Aekkee/YB-Phoenix/1. Team and Robot Picture/Right robot view.jpg

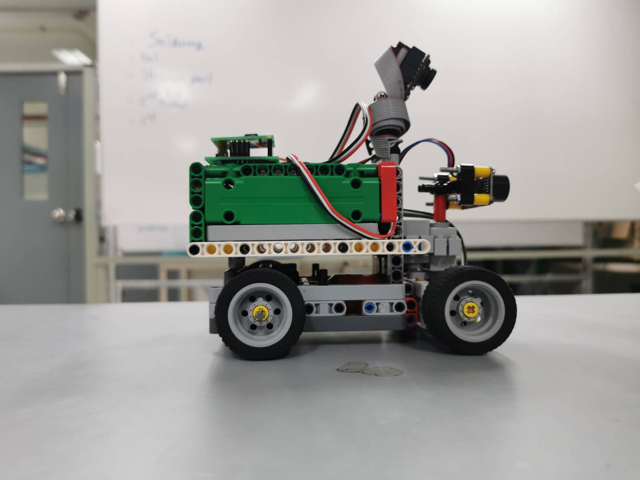
1. Team and Robot Picture/Right robot view.jpg
