Aekkee/YB-Phoenix/National Round (For EV3 users)/README.md

# WRO Future Engineer EV3 Program [Pheonix]
### _By [Yothinburana School Robot Club]_

N|Solid (https://nodesource.com/products/nsolid)

## Youtube Links: 
Currently Unavaiable 

## This Github repository contains:

- Our robot design
- In-depth program explaination
- Other links and references

## **Our Robot Design** ✨
### **Robot Hardware** 💻

- **Motor** - **Power Functions L-Motor (88003)** for **moving** our robot
- **2 Servo** - **KSERVO-270** one for **steering** our robot and another for **rotating ultrasonic sensor**
- **Compass or Gyro** - We use **CMPS-03** compass
- **Camera** - We use **Pixy 2.1** for our robot because of its functionality along with the existing pre-made blocks by the developers
- **Maker Nano RP2040** - The brain for our robot
- **HC-SR04** - An ultrasonic sensor used to measure the distance between the robot and walls  

## **Program Explaination**
### ✨ Our Robot Features ✨

- Proportional Integral Derivative (PID) controlled steering 🚗
- 

As for replicating our robot, we have a **step by step** guide for you.👍

⚠️ **Please note that:** ⚠️
> **We are using LEGO MINDSTORM EV3 for this project.**
> If you **do not** have LEGO MINDSTORM EV3 or are planning on using other microcontrollers I suggest you read this document carefully and please use our program as a guide.

[![N|Solid](https://lh3.googleusercontent.com/fife/AAbDypBhkuFr3Mr7tSym3Jut6JyhcBHJF3AeRYTrl4BHX1edeHbYBvMCN0v1G-UvhWVuRADE4BjWsHMhKEY4IB6p_8vBIARpBFdUQgE92JAFT-g76NMN9wx3w2ewer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)](https://nodesource.com/products/nsolid)

# **1. Setting up your Board and Arduino Software** 🤖
⚠️ **Please Note that** ⚠️
> We are using **Maker nano RP2040** from Cytron Technologies which would need a custom board library

For more information: [Arduino-pico Github]

### **Required Programs**

- **[EV3 Education Lab]** - For Programming your EV3
- **[Pixymon V2]** - For displaying and configuring your Pixy

### **Custom blocks used in EV3 Education Lab**

You need to download these custom made programming blocks to open our program files

- **[OFDL-EV3_Blocks-Collections]** - Add more useful blocks to programming environment
- **[Pixy Blocks and Examples]** - Pixy blocks for your EV3 software with example files

# **2. Programming** 💻
Finally we got to the interesting part ✨
Please, download our EV3 program as a reference, so you can better understand our explainations.

### **Part one:** Setup
This part of our program includes:
- **Determining the robot's direction**  
![](https://lh3.googleusercontent.com/fife/AAbDypD19ichivSvKgow7SBUhvRISVjbeEnMqtdiLCfeoiHsTXGTynDmHaaABd05Rx9MwXgOLXVgILLlzxY_UNUFkmNNxtJBrDTvoTLwKNRpVTRh5O3Hdc8KCTfvFB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)
- **Indicate low battery warning**  
![](https://lh3.googleusercontent.com/fife/AAbDypDL6udCDNcrJpbI75eJKVTb2XgOOONblajD7lleT2Ds3tAuYmS1voNpj4O4uy9p_68-gk1LyinkShpxCgeH9lBCz65OSZfb7PZ5uLUNbl8x__WX-aaYrAVg82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)
- **Move the steering wheels to face the correct position**  
![](https://lh3.googleusercontent.com/fife/AAbDypDoBCUtBNHInyxUW6POKqjqlr32bJ9cwkqRGxk00nqvwL63Sdkmf8O42UpXM3SDPoTTlRFafiBpHbO5Z_WzKHs8AJyCZEET8uj4ZCkqxJmPGTmIcoX5jFx5Ec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)

### **Part two:** Block detection and Robot steering
- **Color detection using Pixy**  
![](https://lh3.googleusercontent.com/fife/AAbDypDo2WOmB2DtCV5U8sR4sGLe_OFGH4g9Vg7N4PIIYmCPscsrt0QWxGzkq1nmktyN6a8tPilJGx2e8ksjzy-kOQZRomiHENlKFdOPSClxG0ji696qcPnnTdN3SC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)
Basically, this part of the program identify which color the Pixy finds. The instructions are as follows:
    - **Adjust robot's path using color signature**  
    ![](https://lh3.googleusercontent.com/fife/AAbDypDAMWveU2Jn_tNErXpLFKThiTEFp8UaaCS-FhQRa7MCt7lQyf8qnEGoLuunH8VuOOTt_DcB_7IdZC9x-ejX6VenEZGjx1oavyO-VwAok2_8s6zkEdiX2gOoWB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)  
    If color is **Red** then **Shift the robot to the right of the block**  
    If color is **Green** then **Shift the robot to the left of the block**  
    ![](https://lh3.googleusercontent.com/fife/AAbDypD4QLQ8vNnnWWcWHOAoVVmfWXYSTS6NW5RJBFBDBHkialNd3rFpNd5DHWMveuq5Bj2PTGkPQn3MXbVjopW1ivrxxkPY_Fma1_2BDrIZE0OYaydA4m9A4oUFFg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)
To put it simple, we are using the **quadratic bezier curve formula** to determine the direction of the robot.

        **But what is a Bezier Curve?**
        > **Bezier Curve** is a parametric curve used in computer graphics and related fields. A set of discrete "control points" defines a smooth, continuous curve by means of a formula. Usually the curve is intended to approximate a real-world shape that otherwise has no mathematical representation or whose representation is unknown or too complicated.  
        
        > **More information about Bezier Curve: [Wikipedia - Bezier Curve] ✨**

        **📌 In our case, we have 4 control points 📌**

        The formula is as follows:  
![](https://lh3.googleusercontent.com/fife/AAbDypATYAYSVzyFyzcO9Y8Lw_bHWmurQLr3pwpLvbIba9qZj3SMmVark8kveDfTkpM0Uf40ed9B-4JJlOhpJCVH2EHxdFsrdnev0wNIUWe1pR4FZqAfuLhohlUk9l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)
        > After we get the **X and Y coordinate** that the robot needs to travel to, we'll **convert that to degrees for the steering wheel motor** by using the following program:  
        
        ![](https://lh3.googleusercontent.com/fife/AAbDypAHzC5M0sBhdJrIlU6XGnXttiSh6ecebvcLrEsPlhhEmdPpX6r7i-wGedJ7vKiie4GmZrbdCkSyfcnlYBCvb7sVNiamjRPEgi-3l1EJ_s702CBq9FDJccZusX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)
    - Adjust robot’s direction by 90 degrees after reaching the turning area  
    ![](https://lh3.googleusercontent.com/fife/AAbDypAqPszHc3wmX25lIkUjvuigtjvkh02RBT9zwXJ_AV8qzvOGWG_Vpqs71u0O5IG7VIEkLieK5CH3fCuK2qOO1kZW4_OymK612jlIEYURUE1EoBGEnZ_VWWkTDZ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)  
    If color is **Blue** then **Adjust the robot's default direction by 90 degrees**  
    ![](https://lh3.googleusercontent.com/fife/AAbDypDWXd5mWcKKQ-gScPsW1K7Q_ZRWQ9TaznbvolquV0dytodjZB6YHIp6K6jnizyMi9ScjEapgEU8xmqhEPYtdyP9QoAFFB_UfUe0PTkm0Pn3gBY1REboFXnHOX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)

### **Part Three:** Critical positions detection
> This part of the program is for **detecting undesired headings of the robot** caused by camera's blocks positions errors, equation errors, etc. 

##### 🟡 A little suggestion from our perspective, 
## we do highly suggest you to ⚠️ **never create a safety critical system** ⚠️ that have a single point of failure. 🍌
We can never rely on the programs we create, so just in case any error occurs, this program would help.

#
#
# 🟢 **[Detection 1]:** Near-hit detection
#### Using the height of the signatures detected by Pixy camera, and the height of the blocks which is 10 centimeter in real life as a reference, **we can calculate the distance between the camera and the blocks!**

> **Formula for calculating the distance of an object:** distance = size_obj * focal_length / size_obj_on_sensor

The program are as follows:  
![](https://lh3.googleusercontent.com/fife/AAbDypCjLyQjF2vqpZjaAAG-T0slBqm0HV24ctHKi_UvyoXKyNPbJK6ab1D-ZnFg1ww3Nec48ieyfoIoRNK_Yg1p1w6CH5ynffmCxAasNZwluHsmaNQroIheo3PfHd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)
##### If the robot detect that it will hit a wall or a block,
#### **the robot will drive in reverse.** ◀️

#
#
# 🟢 **[Detection 2]:** Backup steering
#### This program adjusts the heading of the robot by using values from Pixy camera and Ultrasonic sensors on both side of the robot to **add or subtract the heading degree after the bezier calculation.**  
![](https://lh3.googleusercontent.com/fife/AAbDypDV3Rtvpgkvh6gzzoqJ7U51JMFcOq5YxxtGYS0TlrxSY1K6V_JZgZnD2zn65zdZEs3bwnZTrf989OlazfbahByidTy8rnCBnAsqU0yjdOSmdzYOqjEByyz8x_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)

### **Part Four:** More
The programs in this part is optional and have little effect on the game.
- **Camera test**
Test if the camera is connected to the EV3 MINDSTORM port  
![](https://lh3.googleusercontent.com/fife/AAbDypAMXlgUzxccWHEoJ7KWykB7f46ujeOkY6n4Qe4_v1R4l5G3kUDCIg8IgOFlzirzIxJD7mtJjygEHpQGzEgMt2Sz-Fjoqggl1YK8VXD_W-1kpyogWZsbo4bqEQ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)
- **Compass calibration**
Calibrate the compass  
![](https://lh3.googleusercontent.com/fife/AAbDypBfSTRP_zLe6ElJU3DmDhECoI8SUKoXrNoVhygPmR-7G5bZrRr5LaoHGOdHfR2g08ff1kFfpsh0VxV0GMlQW-b5_oHd6iEwsv-ilc_BkdtpIgDJ6gRUlRCHMP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)

### **Part Five:** Stopping the robot
This part of the robot ensures that the robot **stops in the correct position on the field.**
Basically, the program counts how many time the robot took a 90 degree turn
If it turns more than 4 times the program will run for 1.5 second and the program ends.

# **THE END**
For further questions please email robloxplay41@gmail.com

   [Yothinburana School Robot Club]: <https://ybrobot.club/>
   [Original Flipped Digital Lab]: <https://ofdl.tw/en/>
   [EV3FW-V1.21C-OFDL.bin]: <https://github.com/a10036gt/EV3-BatteryInfo-Block/releases/download/v1.2/EV3FW-V1.21C-OFDL.bin>
   [OFDL-EV3_Blocks-Collections]: <https://github.com/a10036gt/OFDL-EV3_Blocks-Collections/releases/tag/2020.09.12>
   [Pixy Blocks and Examples]: <https://github.com/charmedlabs/pixy/raw/master/releases/lego/lego_pixy-1.1.4.zip>
   [EV3 Education Lab]: <https://e498eb58-16e9-491c-8ce4-828510ab7c41.filesusr.com/archives/1f66bb_4708cf7510f64585bd447c26a4110fc5.zip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>
   [Pixymon V2]: <https://github.com/charmedlabs/pixy/raw/master/releases/pixymon_windows/pixymon_windows-2.0.9.exe>
   [Wikipedia - Bezier Curve]: <https://en.wikipedia.org/wiki/B%C3%A9zier_curve>
   [Arduino-pico Github]: <https://github.com/earlephilhower/arduino-pico>
