Aekkee/YB-Phoenix/1. Team and Robot Picture/Back robot view.jpg

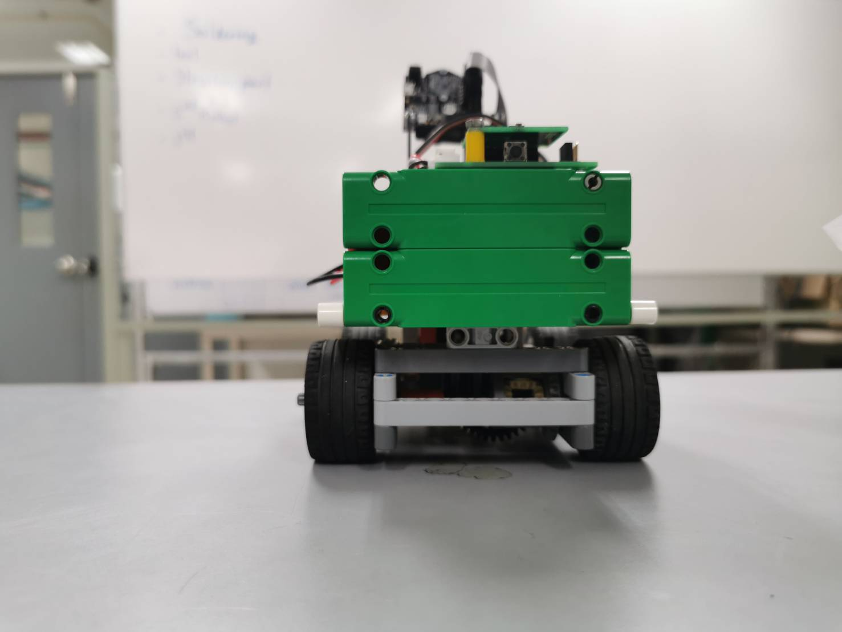
1. Team and Robot Picture/Back robot view.jpg
