Aekkee/YB-Phoenix/1. Team and Robot Picture/Bottom robot view.jpg

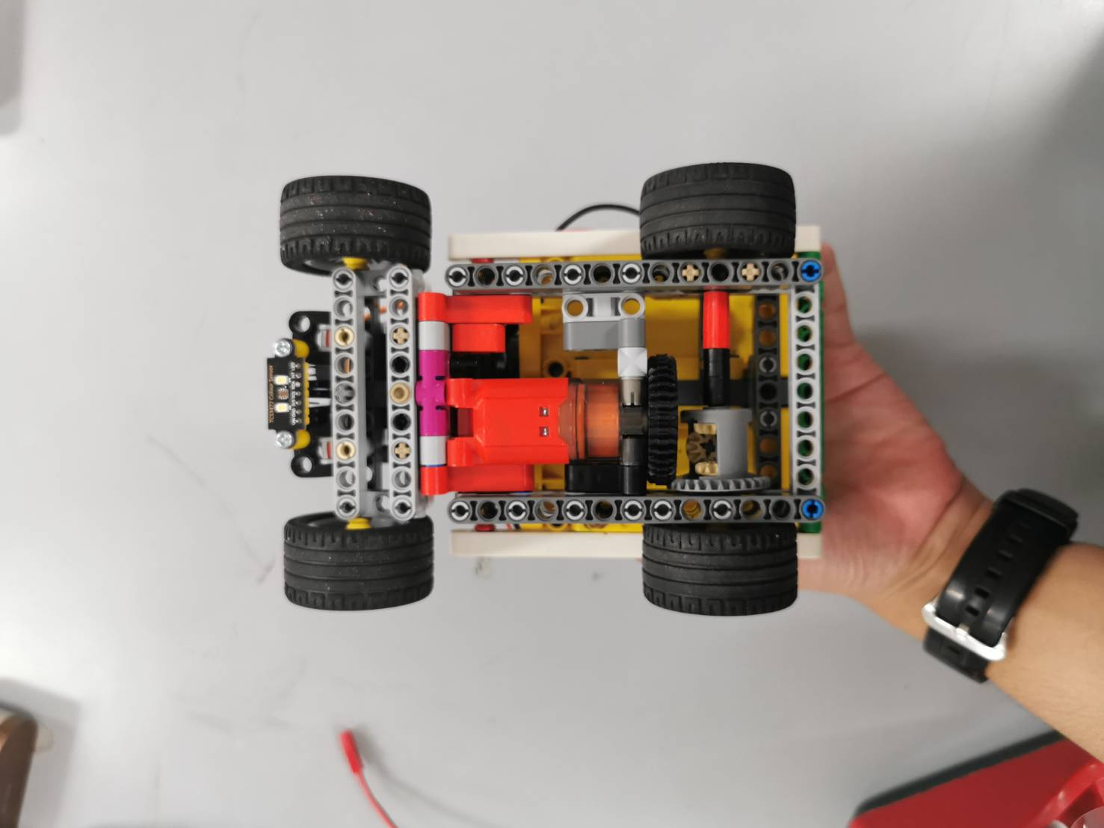
1. Team and Robot Picture/Bottom robot view.jpg
