Aekkee/YB-Phoenix/1. Team and Robot Picture/Front robot view.jpg

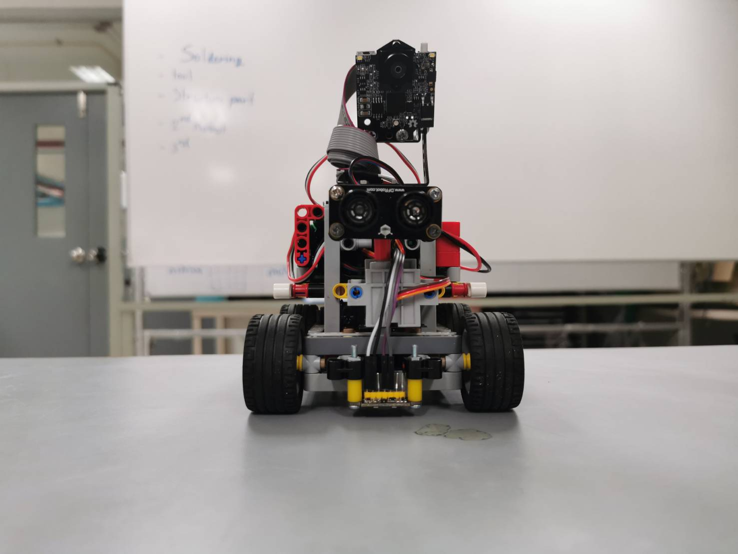
1. Team and Robot Picture/Front robot view.jpg
