Aekkee/YB-Phoenix/1. Team and Robot Picture/Left robot view.jpg

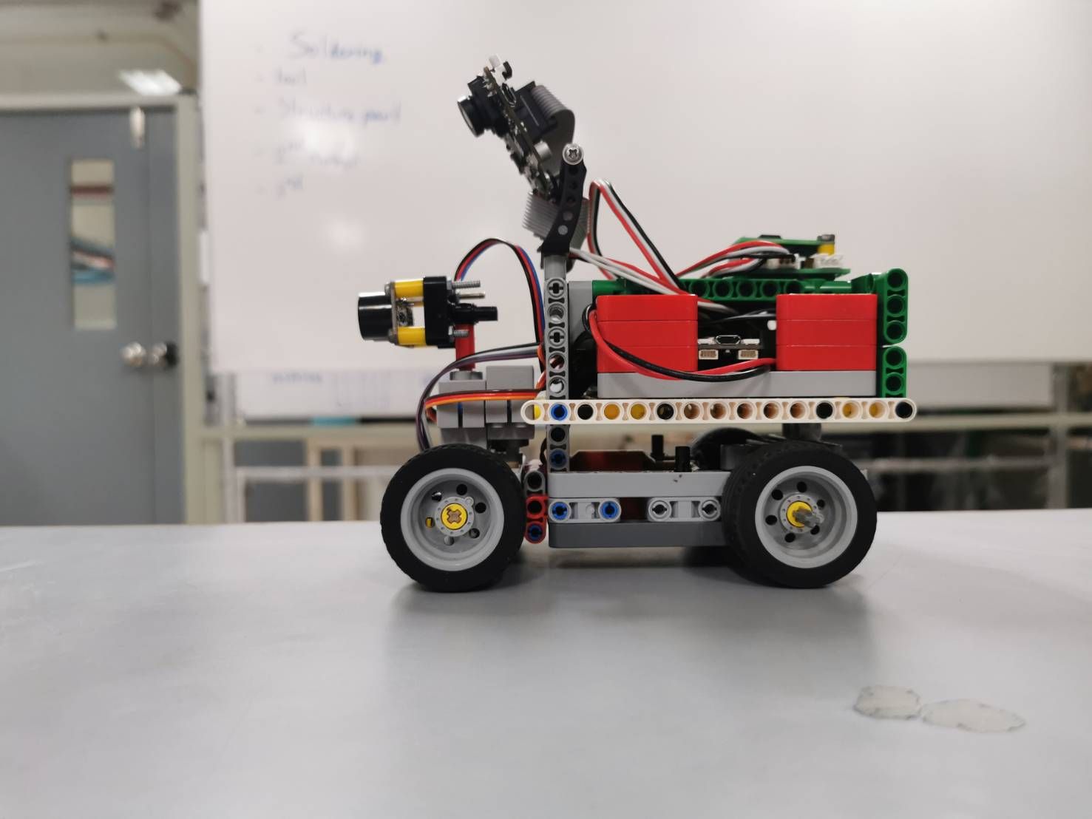
1. Team and Robot Picture/Left robot view.jpg
