Aekkee/YB-Phoenix/1. Team and Robot Picture/More Team Picture.jpg

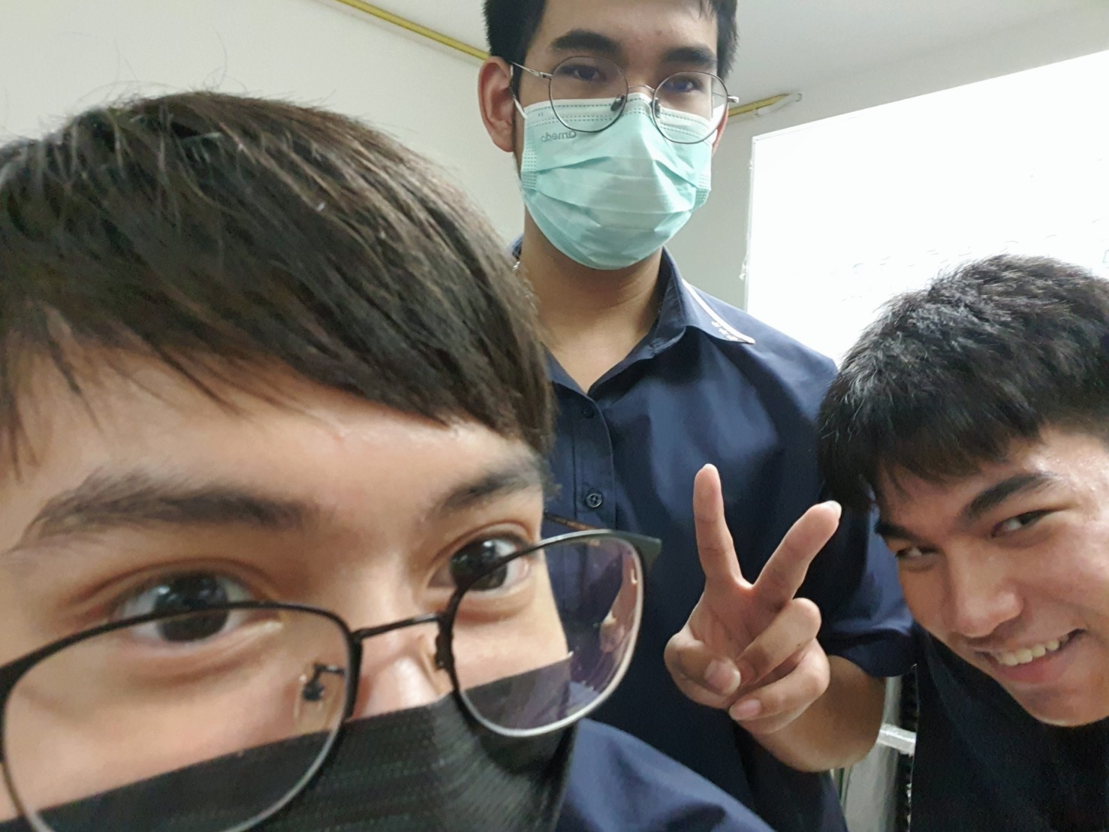
1. Team and Robot Picture/More Team Picture.jpg
