Aekkee/YB-Phoenix/1. Team and Robot Picture/Team Picture.jpg

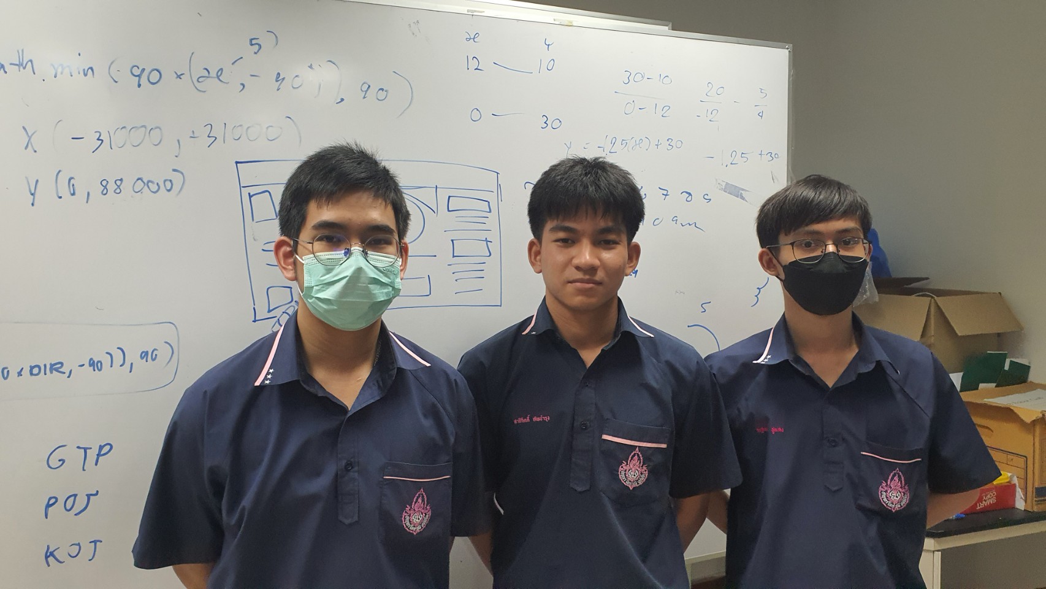
1. Team and Robot Picture/Team Picture.jpg
