Aekkee/YB-Phoenix/1. Team and Robot Picture/Top robot view.jpg

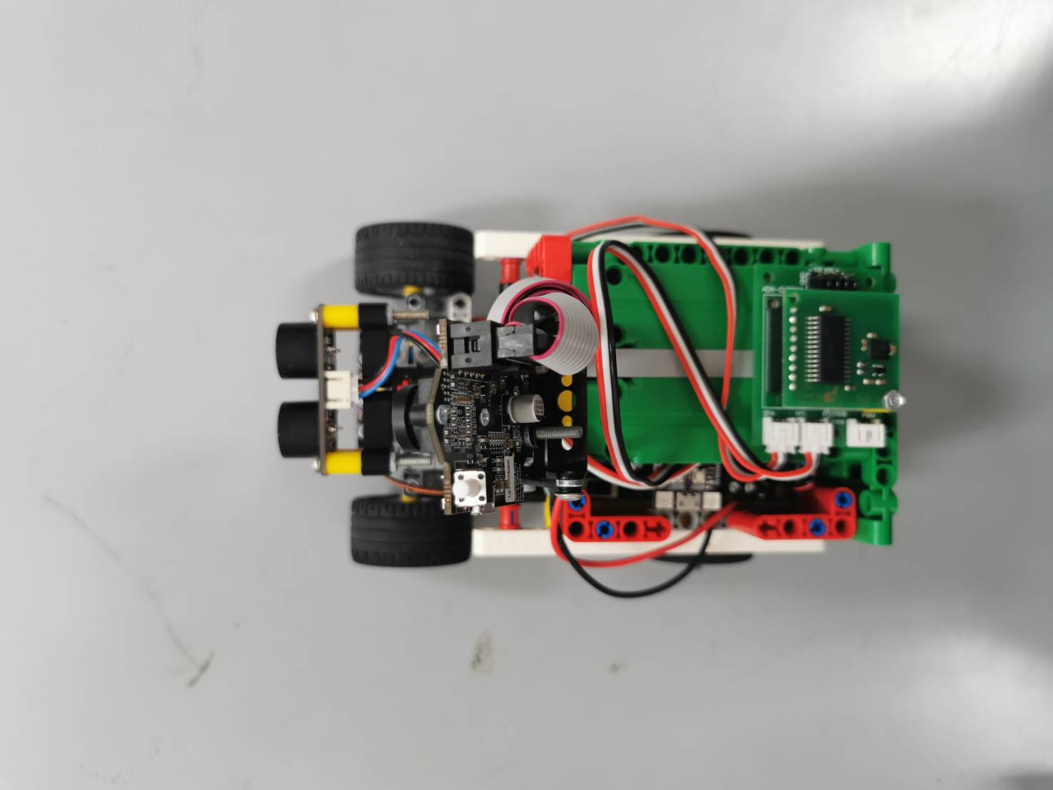
1. Team and Robot Picture/Top robot view.jpg
