Aekkee/YB-Phoenix/4. Schematic diagrams/PCB_github.png

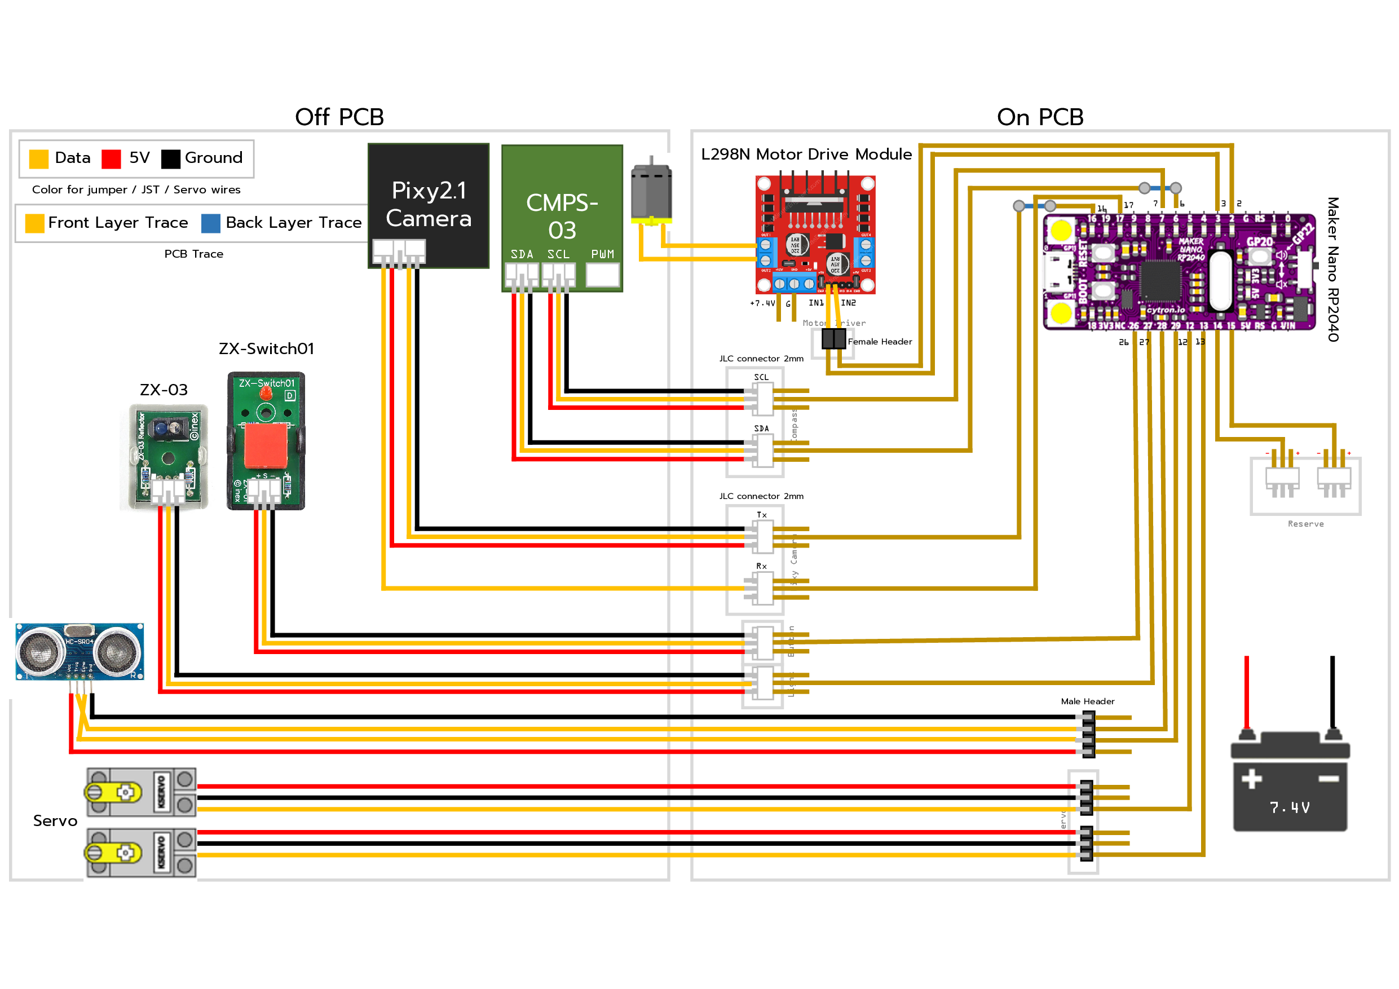
4. Schematic diagrams/PCB_github.png
