Aekkee/YB-Phoenix/4. Schematic diagrams/Schematics yb.png

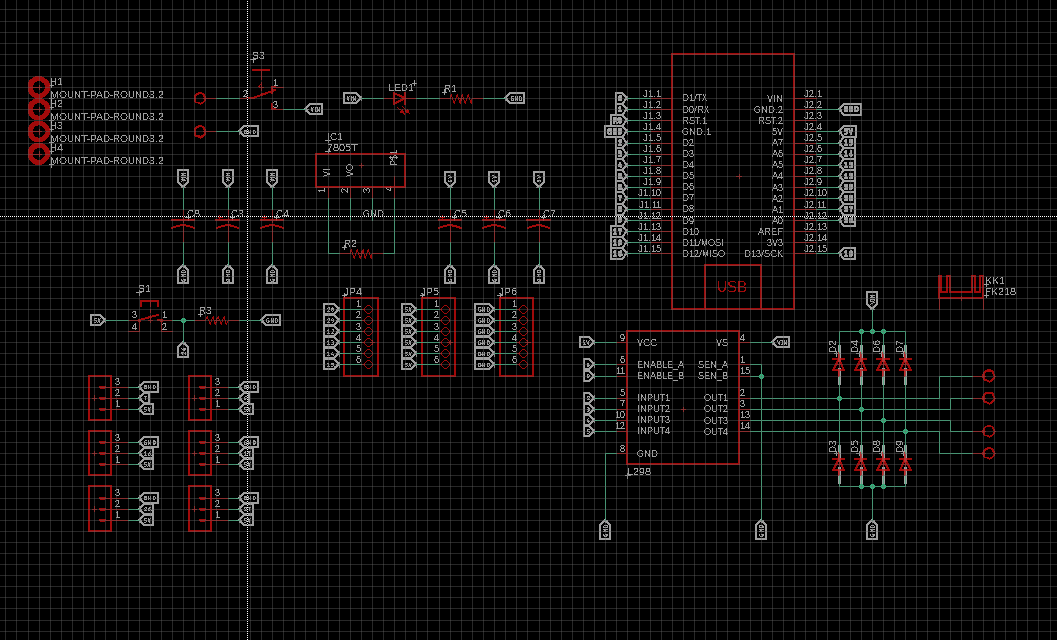
4. Schematic diagrams/Schematics yb.png
