Aekkee/YB-Phoenix/National Round (For EV3 users)/Diagram/Slide1(1).png

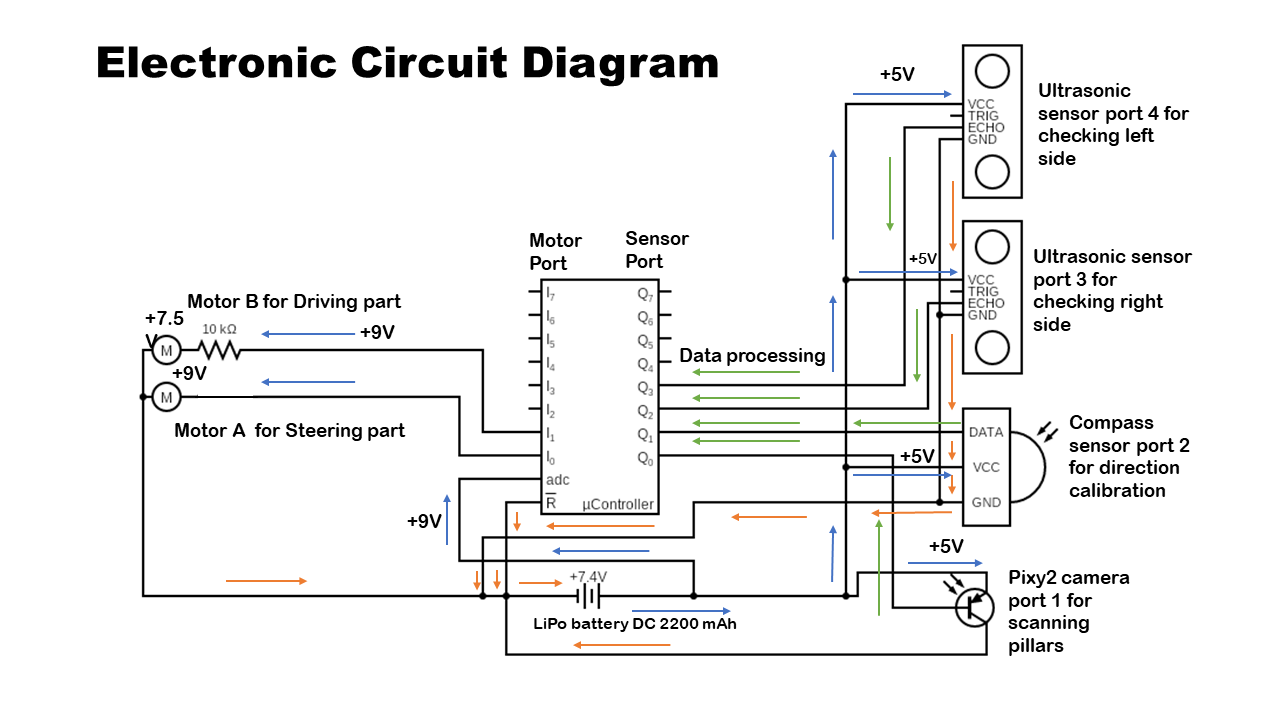
National Round (For EV3 users)/Diagram/Slide1(1).png
