Aekkee/YB-Phoenix/National Round (For EV3 users)/Diagram/Slide2.png

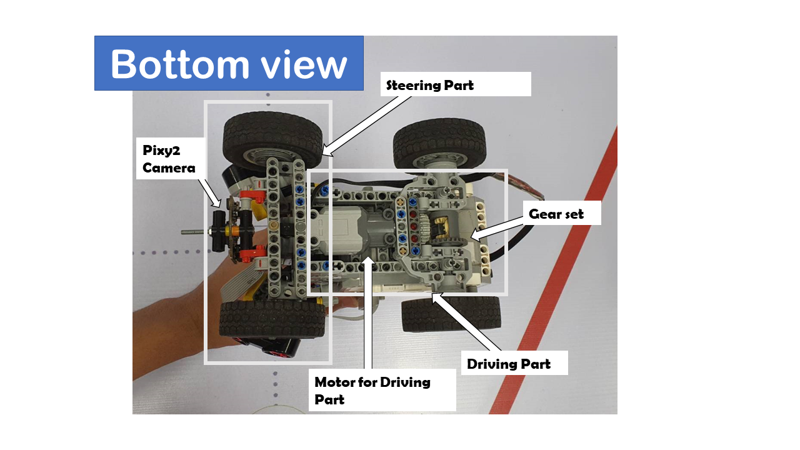
National Round (For EV3 users)/Diagram/Slide2.png
