Aekkee/YB-Phoenix/National Round (For EV3 users)/Diagram/Slide3.png

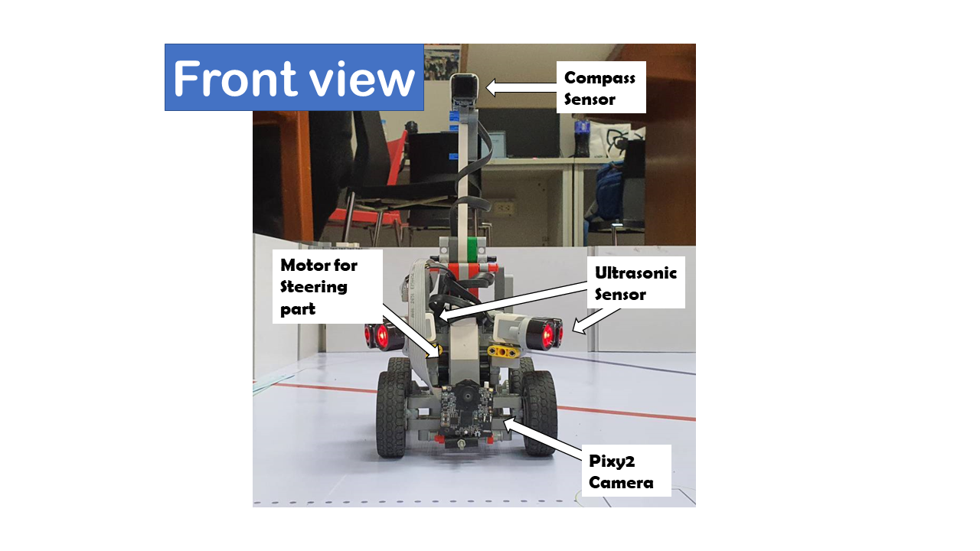
National Round (For EV3 users)/Diagram/Slide3.png
