Aekkee/YB-Phoenix/National Round (For EV3 users)/Diagram/Slide4.png

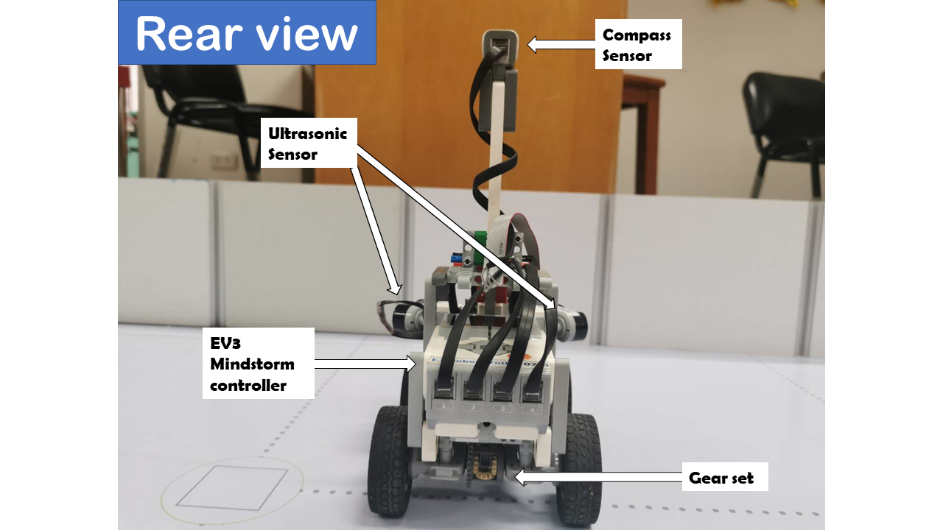
National Round (For EV3 users)/Diagram/Slide4.png
