Aekkee/YB-Phoenix/National Round (For EV3 users)/Diagram/Slide5.png

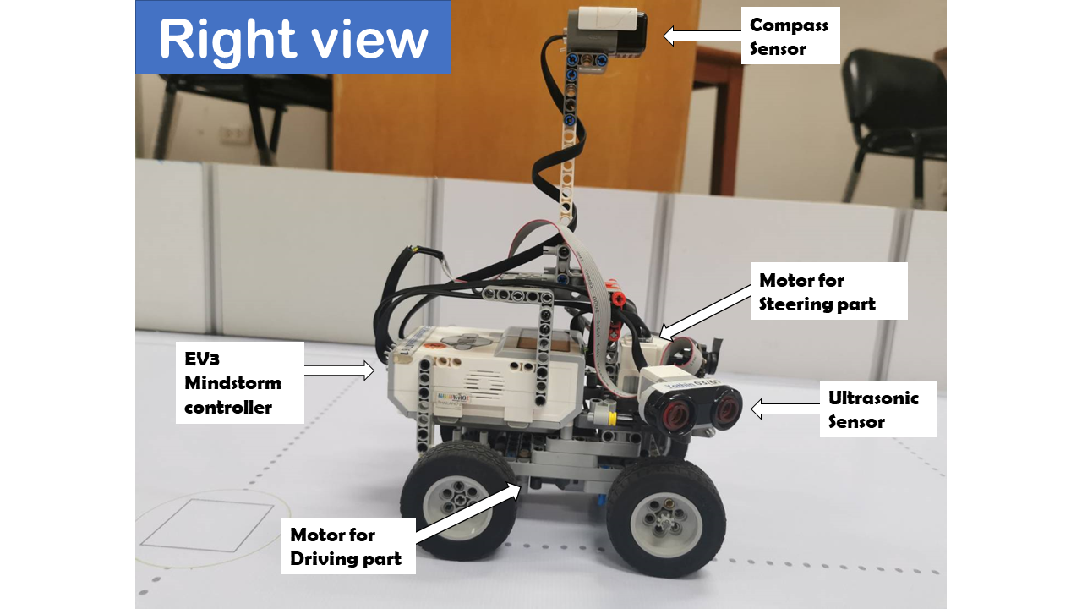
National Round (For EV3 users)/Diagram/Slide5.png
