Aekkee/YB-Phoenix/National Round (For EV3 users)/Diagram/Slide6.png

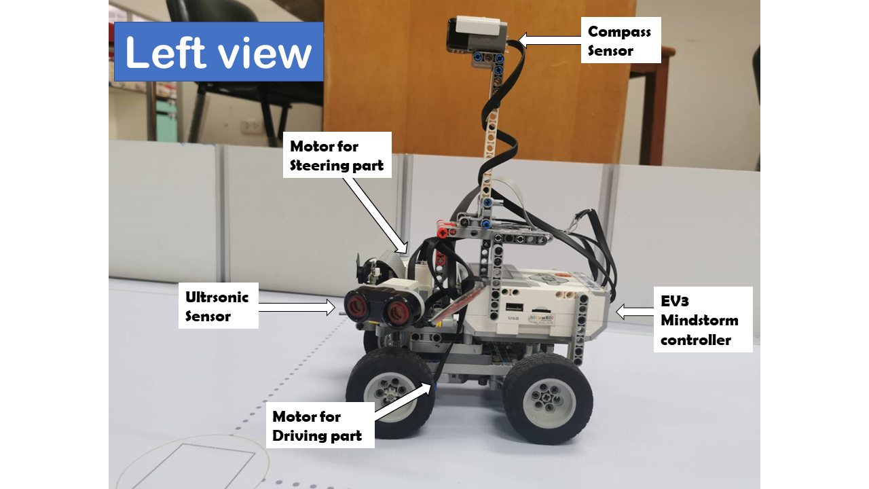
National Round (For EV3 users)/Diagram/Slide6.png
