Aekkee/YB-Phoenix/National Round (For EV3 users)/Team and Robot Picture/Robot Bottom.jpg

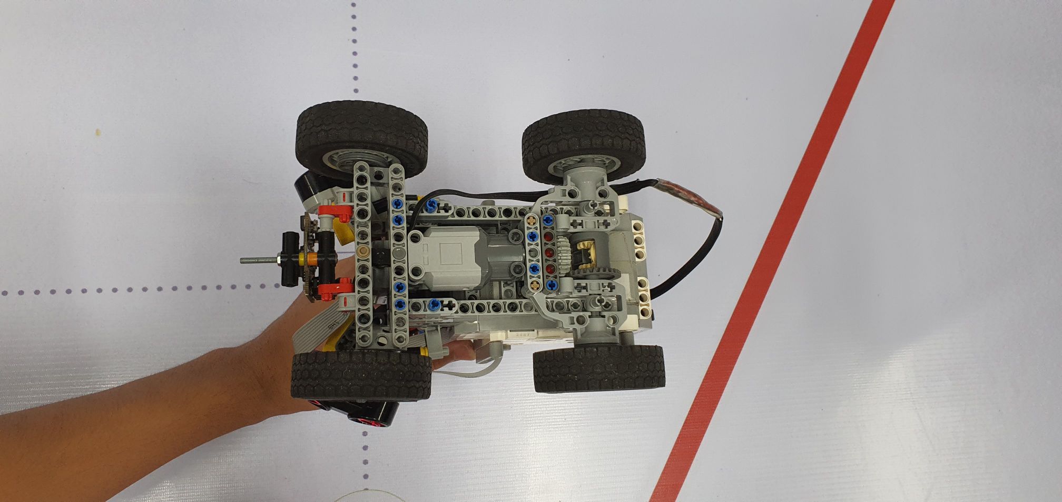
National Round (For EV3 users)/Team and Robot Picture/Robot Bottom.jpg
